rah1236/BNOCAN/BNOCAN/BNOCAN.pdf

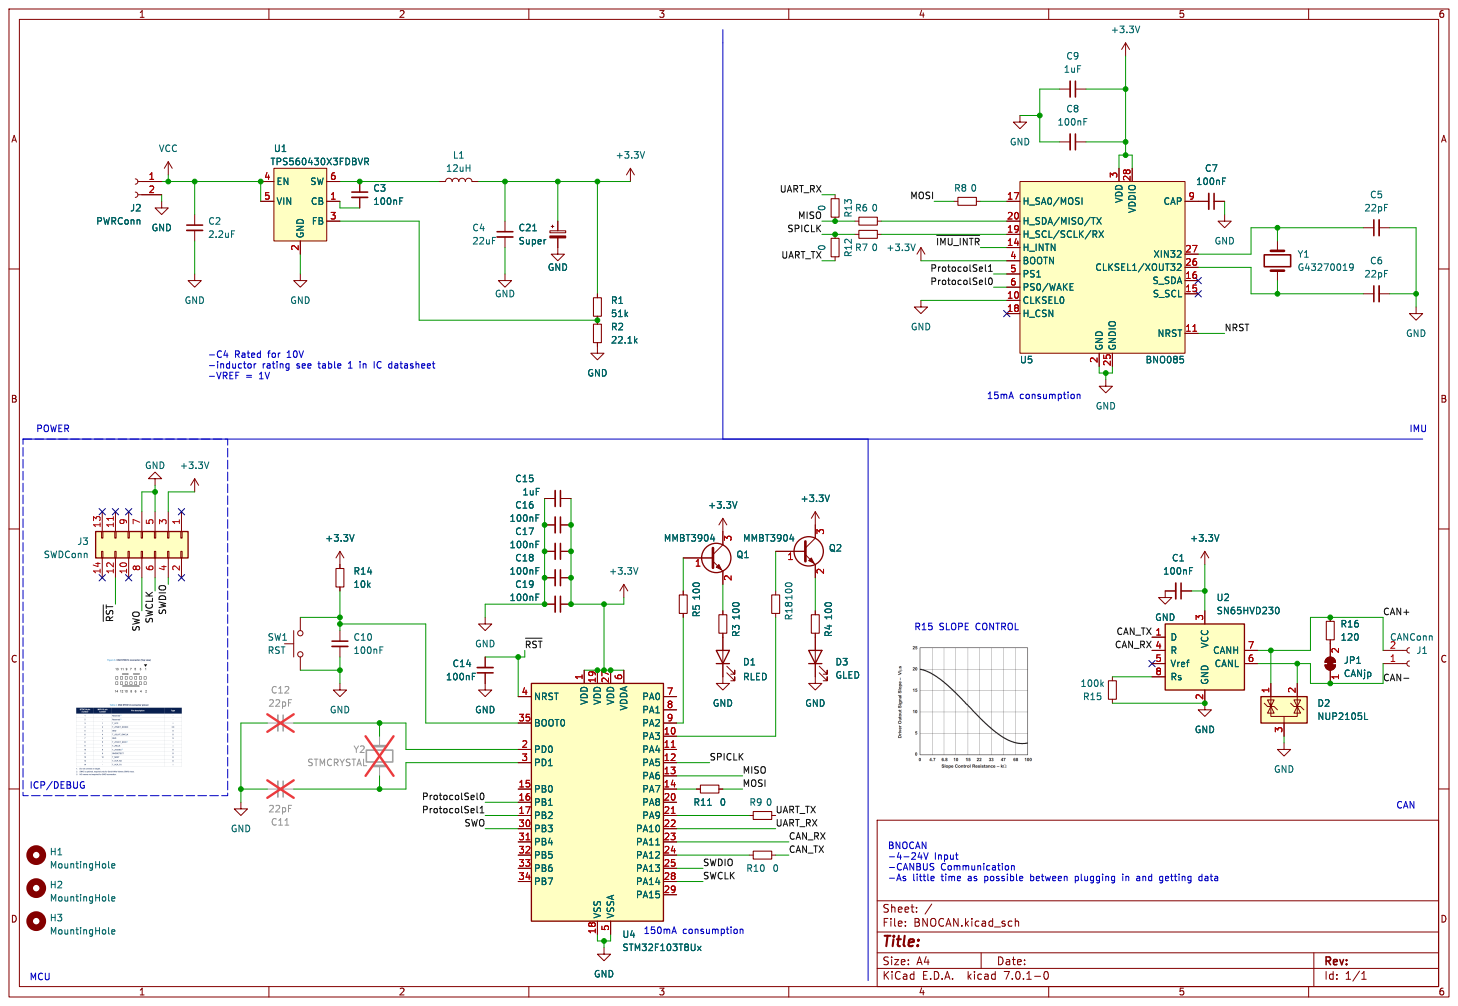
[picture p1: page 1]

2 FB 3 EN 4 VIN 5 SW 6 U1 TPS560430X3FDBVR

2 FB 3 EN 4 VIN 5 SW 6 GND

2 H_SDA/MISO/TX 20 GNDIO 25 CLKSEL1/XOUT32 26 XIN32 27 VDDIO 28 VDD

3 BOOTN 4 PS1 5 PS0/WAKE 6 CAP 9 GND

1 PA3 10 PA4 11 PA5 12 PA6 13 PA7 14 PB0 15 PB1 16 PB2 17 VSS 18 VDD 19 PD0 2 PA8 20 PA9 21 PA10 22 PA11 23 PA12 24 PA13 25 VDD 27 PA14 28 PA15 29 PD1 3 PB3 30 PB4 31 PB5 32 PB6 33 PB7 34 BOOT0 35 NRST 4 VSSA
