rah1236/BNOCAN/BNOCAN/BNOCAN.kicad_pcb

## KiCad design BNOCAN/BNOCAN.kicad_pcb (2024-04-07)

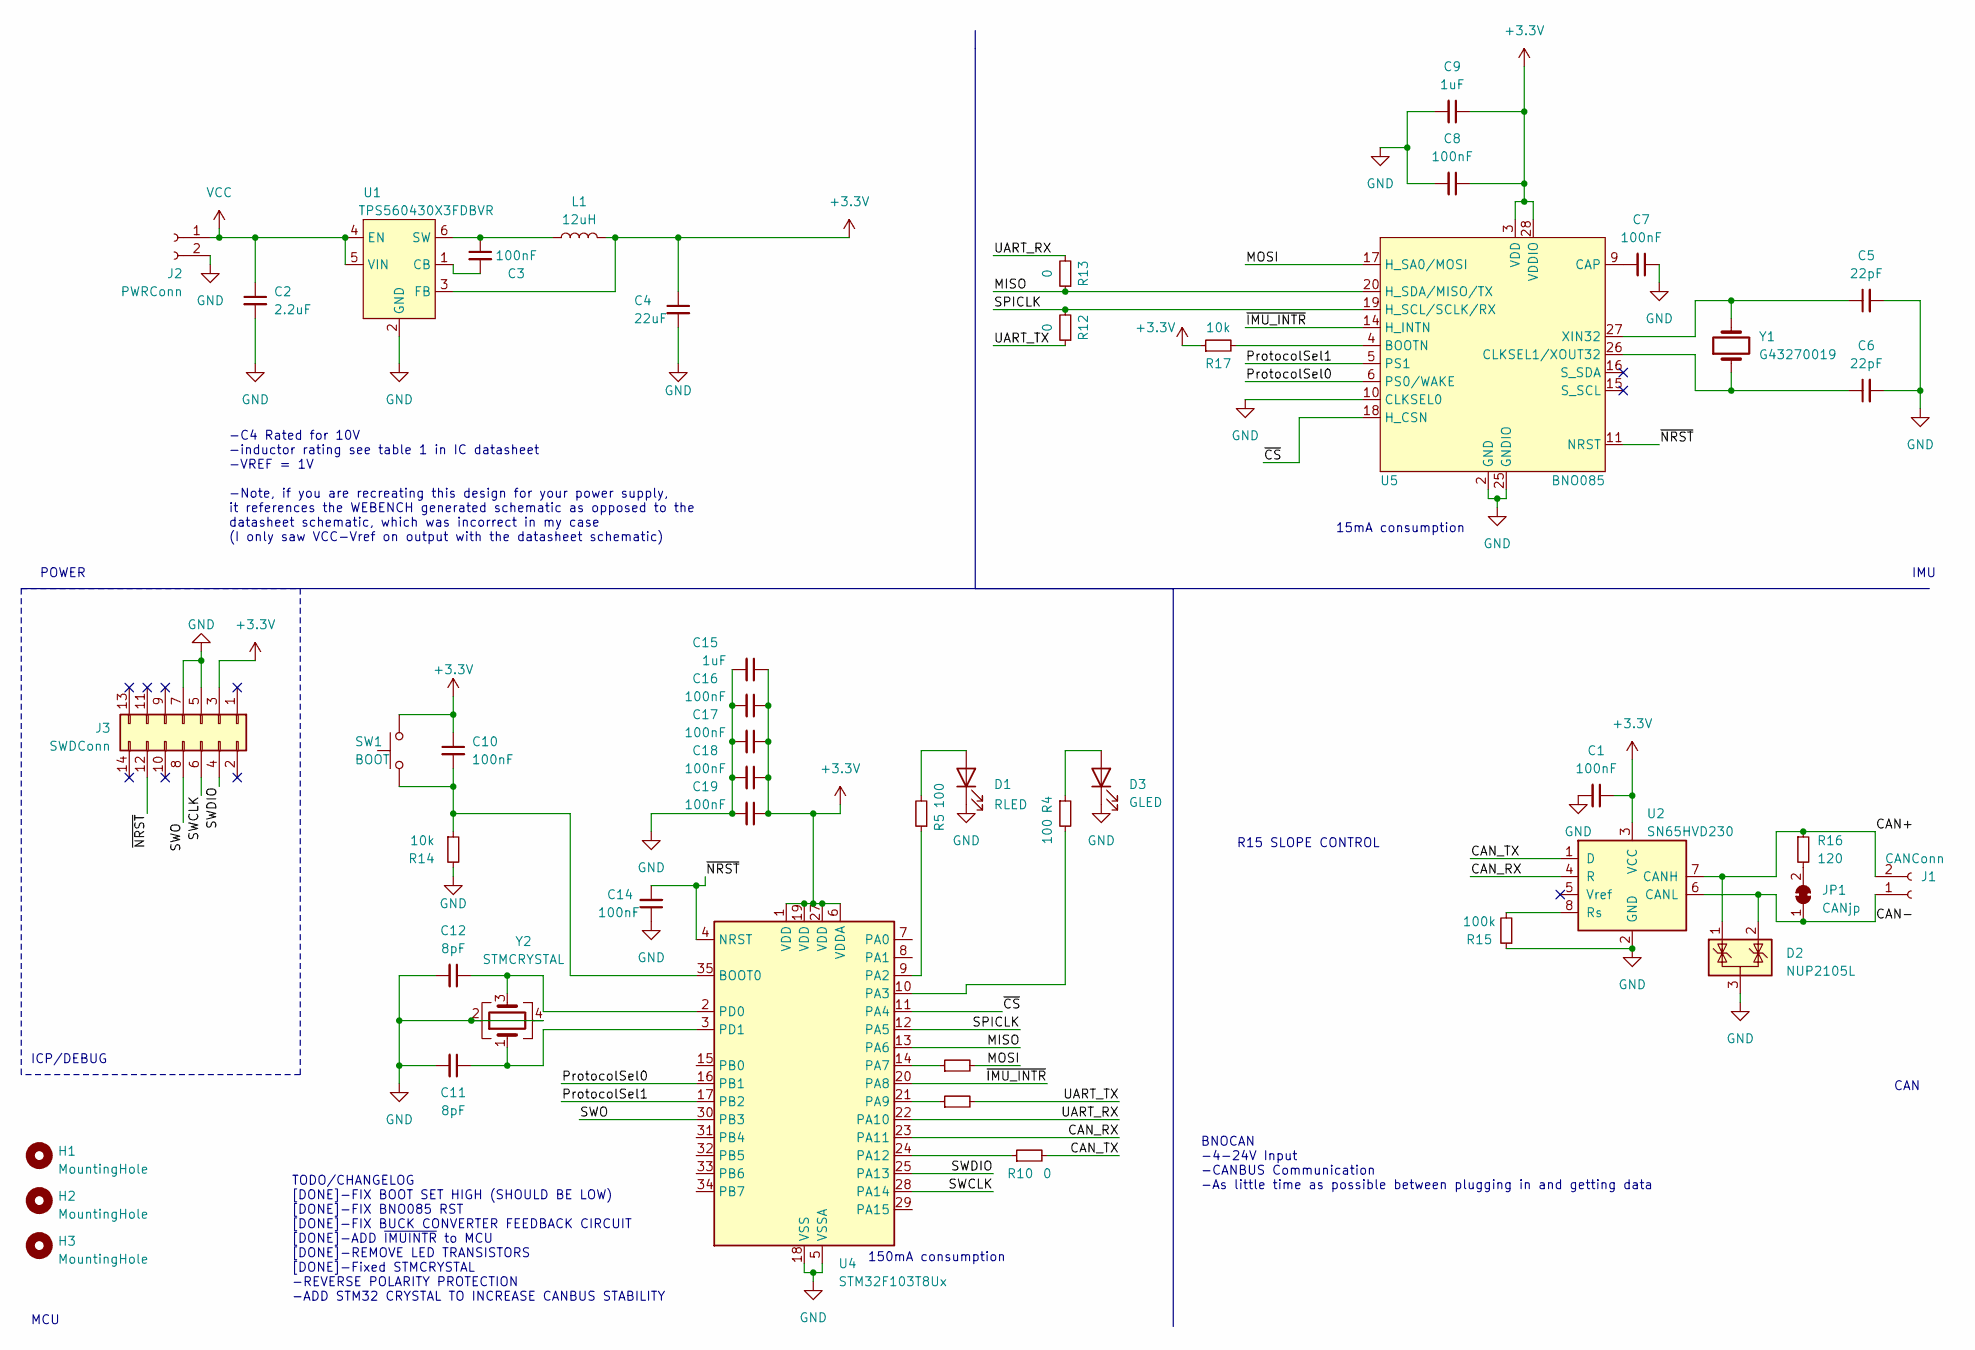
[picture p2: schematic BNOCAN.kicad_sch]

Parts:
C1, C3, C7, C8, C10, C14, C16, C17, C18, C19: 100nF; C_0402_1005Metric
C2: 2.2uF; C_0603_1608Metric
C4: 22uF; C_0402_1005Metric
C5, C6: 22pF; C_0402_1005Metric
C9, C15: 1uF; C_0603_1608Metric
C11, C12: 8pF; C_0402_1005Metric
D1: RLED; LED_0603_1608Metric
D2: NUP2105L; SOT-23
D3: GLED; LED_0603_1608Metric
H1, H2, H3: MountingHole; MountingHole_3.2mm_M3
J1: CANConn; SolderWire-0.15sqmm_1x02_P4mm_D0.5mm_OD1.5mm_Relief
J2: PWRConn; SolderWire-0.15sqmm_1x02_P4mm_D0.5mm_OD1.5mm_Relief
J3: SWDConn; PinHeader_2x07_P1.27mm_Vertical_SMD
JP1: CANjp; PinHeader_1x02_P2.54mm_Vertical
L1: 12uH; L_1210_3225Metric
R4, R5: 100; R_0402_1005Metric
R9, R10, R11, R12, R13: 0; R_0402_1005Metric
R14, R17: 10k; R_0603_1608Metric
R15: 100k; R_0603_1608Metric
R16: 120; R_0805_2012Metric_Pad1.20x1.40mm_HandSolder
SW1: BOOT; SW_SPST_TL3305A
U1: TPS560430X3FDBVR; SOT-23-6
U2: SN65HVD230; SOIC-8_3.9x4.9mm_P1.27mm
U4: STM32F103T8Ux; QFN-36-1EP_6x6mm_P0.5mm_EP4.1x4.1mm
U5: BNO085; LGA-28_5.2x3.8mm_P0.5mm
Y1: G43270019; Crystal_SMD_3215-2Pin_3.2x1.5mm
Y2: STMCRYSTAL; Crystal_SMD_3225-4Pin_3.2x2.5mm

Connections:
+3.3V: C1.1, C4.1, C8.1, C9.1, C10.1, C15.1, C16.1, C17.1, C18.1, C19.1, J3.3, L1.2, R17.1, SW1.2, U1.3 (FB), U2.3 (VCC), U4.1 (VDD), U4.6 (VDDA), U4.19 (VDD), U4.27 (VDD), U5.3 (VDD), U5.28 (VDDIO)
/CAN+: D2.1 (K), J1.2, R16.1, U2.7 (CANH)
/CAN-: D2.2 (K), J1.1, JP1.1 (A), U2.6 (CANL)
/CAN_RX: U2.4 (R), U4.23 (PA11)
/CAN_TX: R10.2, U2.1 (D)
/MISO: R13.1, U4.13 (PA6), U5.20 (H_SDA/MISO/TX)
/MOSI: R11.2, U5.17 (H_SA0/MOSI)
/ProtocolSel0: U4.16 (PB1), U5.6 (PS0/WAKE)
/ProtocolSel1: U4.17 (PB2), U5.5 (PS1)
/SPICLK: R12.2, U4.12 (PA5), U5.19 (H_SCL/SCLK/RX)
/SWCLK: J3.6, U4.28 (PA14)
/SWDIO: J3.4, U4.25 (PA13)
/SWO: J3.8, U4.30 (PB3)
/UART_RX: R13.2, U4.22 (PA10)
/UART_TX: R9.2, R12.1
/~CS: U4.11 (PA4), U5.18 (H_CSN)
/~IMU_INTR: U4.20 (PA8), U5.14 (H_INTN)
/~NRST: C14.2, J3.12, U4.4 (NRST), U5.11 (NRST)
GND: C1.2, C2.2, C4.2, C5.2, C6.2, C7.1, C8.2, C9.2, C11.2, C12.2, C14.1, C15.2, C16.2, C17.2, C18.2, C19.2, D1.1 (K), D2.3 (A), D3.1 (K), J2.2, J3.5, J3.7, R14.2, R15.1, U1.2 (GND), U2.2 (GND), U4.5 (VSSA), U4.18 (VSS), U4.26 (VSS), U4.36 (VSS), U4.37 (VSS), U5.2 (GND), U5.10 (CLKSEL0), U5.25 (GNDIO), Y2.2, Y2.4
unnamed: D1.2 (A), R5.2
unnamed: D3.2 (A), R4.1
unnamed: JP1.2 (B), R16.2
unnamed: C3.2, U1.1 (CB)
unnamed: C3.1, L1.1, U1.6 (SW)
unnamed: R15.2, U2.8 (Rs)
unnamed: C10.2, R14.1, SW1.1, U4.35 (BOOT0)
unnamed: R5.1, U4.9 (PA2)
unnamed: R4.2, U4.10 (PA3)
unnamed: R11.1, U4.14 (PA7)
unnamed: R9.1, U4.21 (PA9)
unnamed: R10.1, U4.24 (PA12)
unnamed: C12.1, U4.2 (PD0), Y2.3
unnamed: C11.1, U4.3 (PD1), Y2.1
unnamed: R17.2, U5.4 (BOOTN)
unnamed: C7.2, U5.9 (CAP)
unnamed: C6.1, U5.26 (CLKSEL1/XOUT32), Y1.1
unnamed: C5.1, U5.27 (XIN32), Y1.2
VCC: C2.1, J2.1, U1.4 (EN), U1.5 (VIN)

Notes on the sheet:
R15 SLOPE CONTROL
ICP/DEBUG
BNOCAN -4-24V Input -CANBUS Communication -As little time as possible between plugging in and getting data
15mA consumption
MCU
IMU
-C4 Rated for 10V -inductor rating see table 1 in IC datasheet -VREF = 1V -Note, if you are recreating this design for your power supply, it references the WEBENCH generated schematic as opposed to the datasheet schematic, which was incorrect in my case (I only saw VCC-Vref on output with the datas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
CAN
TODO/CHANGELOG [DONE]-FIX BOOT SET HIGH (SHOULD BE LOW) [DONE]-FIX BNO085 RST [DONE]-FIX BUCK CONVERTER FEEDBACK CIRCUIT [DONE]-ADD ~{IMUINTR} to MCU [DONE]-REMOVE LED TRANSISTORS [DONE]-Fixed STMCRYSTAL -REVERSE POLARITY PROTECTION -ADD STM32 CRYSTAL TO INCREASE CANBUS STABILITY
POWER
150mA consumption

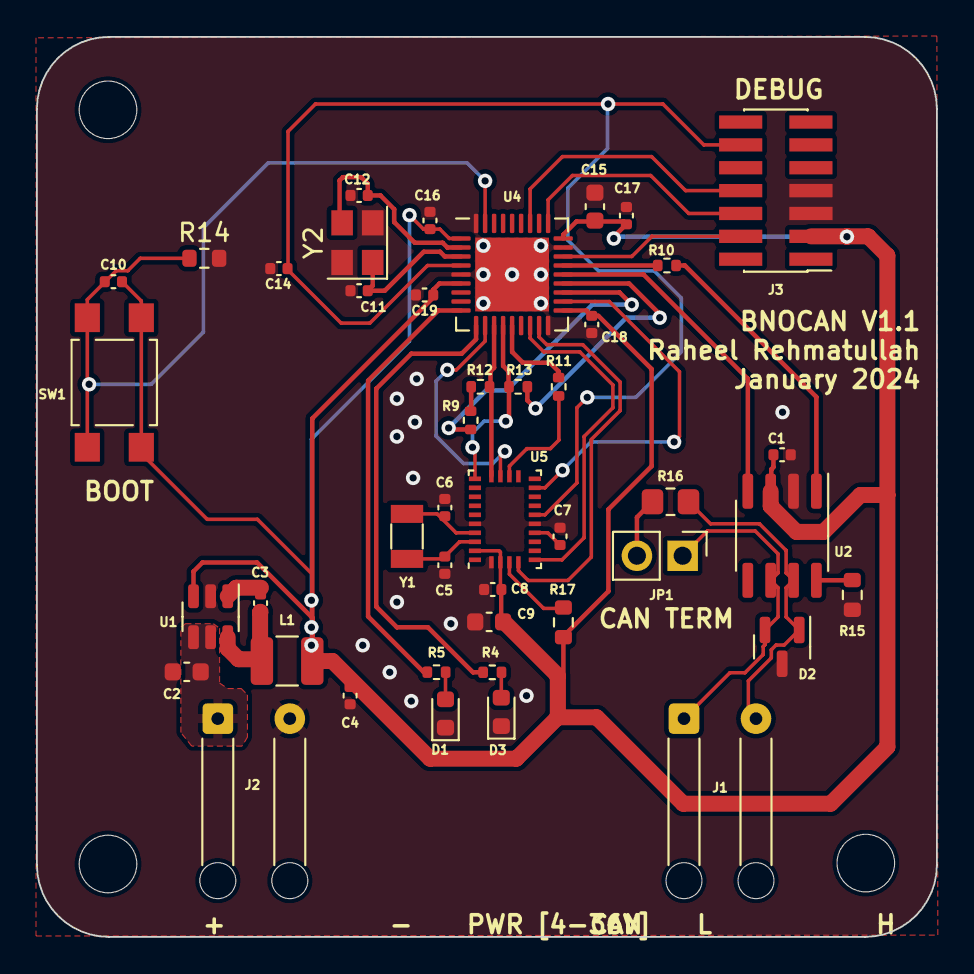
[picture p3: board BNOCAN.kicad_pcb from above]

Board: 2 copper layers, 50.0 x 50.0 mm, 47 parts (0 on the bottom side), 38 nets.
