rah1236/BNOCAN/BNOCAN_FIRMWARE/Core/Src/main.c

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
/* Includes ------------------------------------------------------------------*/
#include "main.h"

/* USER CODE BEGIN Includes */
#include "stdio.h"
#define REVERSE_BITS(byte) ((byte * 0x0202020202ULL & 0x010884422010ULL) % 1023)
#define reverse_bytes_8(num) ( ((num & 0xF0) >> 4) | ((num & 0x0F) << 4) )

/* USER CODE END Includes */

CAN_HandleTypeDef hcan;

TIM_HandleTypeDef htim2;

UART_HandleTypeDef huart1;

void SystemClock_Config(void);
static void MX_GPIO_Init(void);
static void MX_CAN_Init(void);
static void MX_TIM2_Init(void);
static void MX_USART1_UART_Init(void);
/* USER CODE BEGIN 0 */

//Create header variables for incoming and outgoing CAN messages
CAN_TxHeaderTypeDef TxHeader;
CAN_RxHeaderTypeDef RxHeader;

//Create an array of CAN TX mailboxes (The F103 only supports up to 3 mailboxes!)
uint32_t TxMailbox[3];

//Create buffers for TX and RX CAN messages
uint8_t TxData[8];
uint8_t RxData[8];

//Create buffers for the UART RX messages
uint8_t uartRxData[19];

//Index for BNO085 Data alignment
uint8_t IndexOfPacketPrefix;
//Define the expected BNO085 packet prefix
#define PACKET_PREFIX 0xAAAA


//Upon receiving a CAN message
void HAL_CAN_RxFifo0MsgPendingCallback(CAN_HandleTypeDef *hcan)
{
	//Get a CAN frame from the Rx FIFO zone into the message RAM.
	HAL_CAN_GetRxMessage(hcan, CAN_RX_FIFO0, &RxHeader, RxData);
}
/* USER CODE END 0 */

/**
  * @brief  The application entry point.
  * @retval int
  */
int main(void)
{

  /* MCU Configuration--------------------------------------------------------*/

  /* Reset of all peripherals, Initializes the Flash interface and the Systick. */
  HAL_Init();

  /* Configure the system clock */
  SystemClock_Config();

  /* Initialize all configured peripherals */
  MX_GPIO_Init();
  MX_CAN_Init();
  MX_TIM2_Init();
  MX_USART1_UART_Init();
  /* USER CODE BEGIN 2 */

  /* Set the Protocol Select lines for the BNO085,
   * PS1 LOW and PS0 HIGH on boot sets the IMU to RVC (Robot Vacuum Cleaner)
   * mode. Which streams all data through the UART bus. Read the data sheet for more information.
   */
  HAL_GPIO_WritePin(GPIOB, PS1_Pin, GPIO_PIN_RESET);
  HAL_GPIO_WritePin(GPIOB, PS0_WAKE_Pin, GPIO_PIN_SET);

  //Start the CAN peripheral
  HAL_CAN_Start(&hcan);
  //Enable interrupts upon receiving CAN messages
  HAL_CAN_ActivateNotification(&hcan, CAN_IT_RX_FIFO0_MSG_PENDING);


  //Turn on Green LED
  HAL_TIM_PWM_Start(&htim2, TIM_CHANNEL_3); //GREEN LED or D3


  //Define CAN TX header
  TxHeader.DLC = 2;
  TxHeader.ExtId = 0;
  TxHeader.IDE = CAN_ID_STD;
  TxHeader.RTR = CAN_RTR_DATA;
  TxHeader.StdId = 0x111;
  TxHeader.TransmitGlobalTime = DISABLE;

  //Define CAN TX Data
  TxData[0] = 0x01;
  TxData[1] = 0x02;




//  if (HAL_CAN_AddTxMessage(&hcan, &TxHeader, &TxData[0], &TxMailbox[0]) != HAL_OK)
//  {
//	  Error_Handler();
//  }
//  if (HAL_CAN_AddTxMessage(&hcan, &TxHeader, &TxData[1], &TxMailbox[1]) != HAL_OK)
//  {
//	  Error_Handler();
//  }
//  if (HAL_CAN_AddTxMessage(&hcan, &TxHeader, &TxData[2], &TxMailbox[2]) != HAL_OK)
//  {
//	  Error_Handler();
//  }


  /* USER CODE END 2 */

  /* Infinite loop */
  /* USER CODE BEGIN WHILE */
  while (1)
  {

	  //Begin reading the UART buffer
	  if(HAL_UART_Receive(&huart1, uartRxData, 19, 1000) == HAL_OK)
	  {
		  //For the first 19 bytes
		  for(int i = 0; i < 19; i++)
		  {
			// Check if this particular set of bytes matches the expected value
			  uint16_t prefix = (uartRxData[i] << 8) | uartRxData[i+1];
			  if(prefix == PACKET_PREFIX)
			  {
				  //note that this is the index to start at
				  IndexOfPacketPrefix = i;

				  //exit the loop
				  i = 0xFFFF;
			  }
		  }

		  // Set the CAN data to send to be equal to the YAW sent by the BNO085
		  // See part 1.2.5.2 in the BNO085 data sheet for more information
		  //DEBUG:
		  //printf("Mailbox before send = %X\n", HAL_CAN_GetTxMailboxesFreeLevel(&hcan));

		  TxData[0] = REVERSE_BITS(uartRxData[IndexOfPacketPrefix + 3]);
		  TxData[1] = REVERSE_BITS(uartRxData[IndexOfPacketPrefix + 4]);
		  // Send that message to the first CAN mailbox
		  if (HAL_CAN_AddTxMessage(&hcan, &TxHeader, &TxData, &TxMailbox[0]) != HAL_OK)
		  {
			  Error_Handler();
		  }
		  //DEBUG:
		  //printf("Mailbox after send = %X\n", HAL_CAN_GetTxMailboxesFreeLevel(&hcan));


		}
	    //DEBUG:
		HAL_Delay(100);
		//<DEBUG>:

    /* USER CODE END WHILE */

    /* USER CODE BEGIN 3 */
  }
  /* USER CODE END 3 */
}

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
/* USER CODE BEGIN 4 */
int _write(int file, char *ptr, int len)
{
  (void)file;
  int DataIdx;

  for (DataIdx = 0; DataIdx < len; DataIdx++)
  {
    ITM_SendChar(*ptr++);
  }
  return len;
}
/* USER CODE END 4 */
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
