rah1236/BNOCAN/BNOCAN_FIRMWARE/BNOCAN_FIRMWARE.ioc

Mcu.UserName=STM32F103T8Ux
PA10.Signal=USART1_RX
PA11.Signal=CAN_RX
PA12.Signal=CAN_TX
PA13.Signal=SYS_JTMS-SWDIO
PA14.Signal=SYS_JTCK-SWCLK
PA2.Signal=S_TIM2_CH3
PA3.GPIO_Label=RED_LED
PA3.Signal=S_TIM2_CH4
PA8.GPIO_Label=IMU_INTR
PA8.Signal=GPXTI8
PA9.Signal=USART1_TX
PB1.GPIO_Label=PS0/WAKE
PB1.Signal=GPIO_Output
PB2.GPIO_Label=PS1
PB2.Signal=GPIO_Output
PB3.Signal=SYS_JTDO-TRACESWO
PD0-OSC_IN.Signal=RCC_OSC_IN
PD1-OSC_OUT.Signal=RCC_OSC_OUT
