rah1236/BNOCAN/BNOCAN_FIRMWARE/Core/Inc/main.h

#define RED_LED_Pin GPIO_PIN_3
#define RED_LED_GPIO_Port GPIOA
#define PS0_WAKE_Pin GPIO_PIN_1
#define PS0_WAKE_GPIO_Port GPIOB
#define PS1_Pin GPIO_PIN_2
#define PS1_GPIO_Port GPIOB
#define IMU_INTR_Pin GPIO_PIN_8
#define IMU_INTR_GPIO_Port GPIOA
