rah1236/BNOCAN/(commit log)

2023-12-19 V1 Ordered
    [BNOCAN-B_Cu.gbr, BNOCAN-B_Mask.gbr, BNOCAN-B_Paste.gbr, BNOCAN-B_Silkscreen.gbr, BNOCAN-Edge_Cuts.gbr, BNOCAN-F_Cu.gbr, BNOCAN-F_Mask.gbr, BNOCAN-F_Paste.gbr]
2024-03-23 V1.1 Produced
    [BNOCAN-B_Cu.gbr, BNOCAN-B_Mask.gbr, BNOCAN-B_Paste.gbr, BNOCAN-B_Silkscreen.gbr, BNOCAN-Edge_Cuts.gbr, BNOCAN-F_Cu.gbr, BNOCAN-F_Mask.gbr, BNOCAN-F_Paste.gbr]
2024-04-07 Firmware Dump + some Board Bug fixes
    [BNOCAN.kicad_pcb, BNOCAN.kicad_sch]
