rah1236/BNOCAN/(notices)

Notices in the files:
BNOCAN_FIRMWARE/Core/Inc/main.h:
Copyright (c) 2024 STMicroelectronics.
All rights reserved.
This software is licensed under terms that can be found in the LICENSE file
